MichaelBell/ttihp25b-tinyQV/test/user_peripherals/prism/chroma_encoder.py

'''
==============================================================
PRISM Downloadable Configuration

Input:    chroma_encoder.sv
Config:   tinyqv.cfg
==============================================================
'''
chroma_encoder = [
   0x00000bc0, 0x0000e000, 
   0x00000bc0, 0x0000c000, 
   0x00000bc0, 0x0000a000, 
   0x00000bd0, 0x00000000, 
   0x00000a41, 0x00000021, 
   0x00000984, 0x20800180, 
   0x00000a84, 0x00806015, 
   0x00000988, 0x20002180, 
]
chroma_encoder_ctrlReg = 0x00003000
