MichaelBell/ttihp25b-tinyQV/test/user_peripherals/prism/chroma_gpio24.py

'''
==============================================================
PRISM Downloadable Configuration

Input:    chroma_gpio24.sv
Config:   tinyqv.cfg
==============================================================
'''
chroma_gpio24 = [
   0x000003c0, 0x08000000, 
   0x000003c0, 0x08000000, 
   0x00000140, 0x08010010, 
   0x00000bc0, 0x0800b200, 
   0x00000140, 0x0801401d, 
   0x00000280, 0x0841601a, 
   0x000003c0, 0x08004000, 
   0x00000288, 0x00012010, 
]
chroma_gpio24_ctrlReg = 0x000005D4
