MichaelBell/ttihp25b-tinyQV/test/user_peripherals/prism/chroma_spislave.py

'''
==============================================================
PRISM Downloadable Configuration

Input:    chroma_spislave.sv
Config:   tinyqv.cfg
==============================================================
'''
chroma_spislave = [
   0x00000bf8, 0x80003a00, 
   0x00000940, 0x00005a1d, 
   0x00000b80, 0x00001a00, 
   0x00000942, 0x0000da03, 
   0x00000b80, 0x00001a00, 
   0x00000a80, 0x20009a03, 
   0x00000a00, 0x80005bc3, 
   0x00000840, 0x00003a00, 
]
chroma_spislave_ctrlReg = 0x00002952
