MichaelBell/ttihp25b-tinyQV/test/user_peripherals/prism/chroma_ws2812.py

'''
==============================================================
PRISM Downloadable Configuration

Input:    chroma_ws2812.sv
Config:   tinyqv.cfg
==============================================================
'''
chroma_ws2812 = [
   0x00000bc0, 0x00001000, 
   0x00000940, 0x0000301d, 
   0x00000aa2, 0x0200d01e, 
   0x00000aa2, 0x0200d016, 
   0x00000aa0, 0x0a01b016, 
   0x00000960, 0x0a01900f, 
   0x00000a90, 0x0a01501e, 
   0x000009b8, 0x20003190, 
]
chroma_ws2812_ctrlReg = 0x00002500
