MichaelBell/ttihp25b-tinyQV/(commit log)

2025-08-14 Add ledstrip font
2025-08-15 No GL power on IHP
2025-08-16 Fixed bug in FPGA synth branch of prism_periph.v
    [prism_periph.v]
2025-08-16 resolve module naming collisions; add reference images for tests
    [char_rom.v, vga_timing.v, vgaconsole.v]
2025-08-17 Fix bug in ALU and bug in test.py
    [pwl_synth.sv, pwl_synth_memory.sv, test.py]
2025-08-17 Add SPI controller
2025-08-18 Fix bug that halved oscillator frequency resolution
    [pwl_synth.sv]
2025-08-19 ledstrip peripheral: cleanup
2025-08-21 Repair broken oscillator, fix potential logic loop
    [pwl_synth.sv]
2025-08-21 VGA console peripheral: robustness fixes
    [vgaconsole.v]
2025-08-27 Antenna tweak
2025-08-28 More antenna iterations
2025-08-28 Fewer antenna iterations
2025-08-31 Fix SPI lint
